Duccuong04/Design-Drone-from-Zero/readme.md

# Project: Design Drone from Zero

## 1. MATLAB Simulink

 Mô phỏng đáp ứng PID & fuzzy PID, đã được trình bày ở file thuyết minh, file MATLAB Simulink ở đây: [***MATLAB Simulink Drone***](<MATLAB Simulink>)

## 2. Hardware

Thiết kế mạch tay cầm cho drone sử dụng IC xử lý chính là STM32F103C8T6, mạch chính drone để điều khiển dùng STM32F407VET6

Các hình ảnh thiết kế được trình bày ở đây: [***Hardware***](Hardware/readme.md)

## 3. Code

Mạch tay cầm: [***Code Game Pad for Drone***](Code/GamePadforDrone)

Mạch xử lý chính: [***Code Main Drone***](Code/MainDrone)

## 4. Kết quả đã đạt được

Test đáp ứng PID với Input là Gyro và Joystick từ tay cầm: 

**https://youtu.be/HaZGvO9cnyQ**

**https://youtu.be/AUR3ovJpVSY**

Test cân bằng góc pitch/ roll

**https://youtu.be/xqhBPt9eMAI**

Video bay thực tế: 

https://drive.google.com/file/d/147RBULrgK9qIRCBWejau6amRLlQyX-BF/view?usp=sharing

Nhận xét:
- Về chức năng: Đã cân bằng được ba góc roll, pitch, yaw sử dụng bộ điều khiển PID. Điều khiển bằng tay cầm đáp ứng tốt
- Thuật toán đếm người sử dụng Camera Rasphberry Pi cho hiệu quả tốt và chính xác
- Dữ liệu GPS truyền về ở chế độ tự động bay còn lỗi, sẽ tiếp tục cải thiện sau
