Duccuong04/Design-Drone-from-Zero/Hardware/Algorithm.pptx

GY86 – IMU9DOF – HMC5883L

## Slide 2

1. Khởi tạo đối tượng IMU

IMU9DOF gy86(&hi2c1,11, 0x080E0000);

IMU9DOF sử dụng I2C1, sector flash = 11, địa chỉ flash = 0x080E0000.

2. Khởi động cảm biến trong main

Init cảm biến

if ((gy86.IsReadyToInterfaceMPU6050() != IMU9DOF_Result_Ok) || (gy86.IsReadyToInterfaceHMC5883L() != IMU9DOF_Result_Ok)) {
// Báo lỗi
}
if (gy86.Init() != HAL_OK) {
// Báo lỗi
}

→ gọi IsReadyToInterfaceMPU6050 / IsReadyToInterfaceHMC5883L để kiểm tra I2C.
→ gọi Init() (bên trong: SetupGyro(), SetupCompass(), SetupAutomaticReadCompass(), đọc/ghi flash để load hệ số calib).

## Slide 3

Chuẩn bị dữ liệu ban đầu

gy86.ReadRawAllParameter();
gy86.ReadCompass();
gy86.angleYaw = gy86.actualCompassHeading;
gy86.CalibGyro(); // hiệu chuẩn Gyro bằng 2000 mẫu

Ổn định giá trị accel trước khi vào vòng lặp chính

for (int i = 0; i <= 24; i++) gy86.shortAverageAccel_Z[i] = gy86.accel.z;
for (int i = 0; i <= 49; i++) gy86.longAverageAccel_Z[i] = gy86.accel.z;
gy86.shortTotalAccel_Z = gy86.accel.z * 25;
gy86.longTotalAccel_Z = gy86.accel.z * 50;

## Slide 4

3. Trong vòng lặp while(1)

Khi stateMachine = 0 (khởi động lần đầu):

gy86.CalibCompass(); // hiệu chỉnh la bàn, ghi vào flash
gy86.CalibLevel(&error); // calib cân bằng mặt phẳng, ghi offset accel vào flash

Trong vòng lặp chính mỗi chu kỳ:

gy86.ReadGyroAccel(); // đọc gyro + accel, trừ offset
gy86.ReadCompass(); // tính toán heading từ magnetometer
gy86.CalculateGyroInput(); // tính roll/pitch/yaw input từ gyro
gy86.ReadAngleRPY(); // tính góc Roll, Pitch, Yaw
gy86.setLevelAdjust(0, 0); // hiệu chỉnh cân bằng
gy86.VerticalAccelerationCalculations(); // tính gia tốc thẳng đứng, hỗ trợ ổn định độ cao

## Slide 5

4. Dòng dữ liệu IMU → PID → Motor

ReadGyroAccel() + ReadCompass() + ReadAngleRPY() → cập nhật gy86.gyro.rollInput, pitchInput, yawInput.

Gán vào PID:

pidForHorizontal.roll.inputValue = gy86.gyro.rollInput;
pidForHorizontal.pitch.inputValue = gy86.gyro.pitchInput;
pidForHorizontal.yaw.inputValue = gy86.gyro.yawInput;

- Sau đó pidForHorizontal.calculatePID() tính toán đầu ra PID.
- Cuối cùng, các giá trị PID + Throttle được cộng/trừ và đưa vào PWM ESC để điều khiển động cơ.

## Slide 6

- IsReadyToInterfaceMPU6050/HMC5883L → kiểm tra kết nối
- Init() → setup gyro + compass + đọc hệ số calib từ flash
- ReadRawAllParameter() + ReadCompass() → lấy giá trị ban đầu
- CalibGyro() → hiệu chuẩn gyro
- Khi stateMachine = 0: CalibCompass() + CalibLevel()
- Trong vòng lặp chính:
- ReadGyroAccel()
- ReadCompass()
- CalculateGyroInput()
- ReadAngleRPY()
- setLevelAdjust()
- VerticalAccelerationCalculations()

## Slide 7

GY86 – MS5611

## Slide 8

1. Khởi tạo đối tượng

Barometer ms5611(&hi2c1);

2. Trong main() – giai đoạn khởi tạo

Thiết lập thông số PID cho barometer:

ms5611.SetKgainPID(1.4, 0.2, 0.75, 400);

Cấu hình hệ số P, I, D và giới hạn đầu ra cho PID giữ độ cao

Kiểm tra kết nối với barometer:

if (ms5611.IsReadyToInterface() != BAROMETER_Result_Ok) {
// lỗi cảm biến -> reset drone
}

Gọi Init():

if (ms5611.Init() != HAL_OK) {
// lỗi init -> reset drone
}

## Slide 9

Hàm Init() gọi Reset() (gửi lệnh reset MS5611) và ReadProm() (đọc hệ số hiệu chuẩn trong PROM)

Ổn định bộ nhớ đệm áp suất trước khi vào vòng lặp chính:

for (int i = 0; i < 100 ; i++) {
ms5611.ReadAndCalculatePIDBarometer(flightMode, takeoffDetected,stateThrottle);
HAL_Delay(4);
}
ms5611.SetGroundPressure();

3. Trong vòng lặp while(1)

Chuẩn bị giá trị trung bình để tránh sai số ban đầu

ms5611.ReadAndCalculatePIDBarometer(flightMode, takeoffDetected, stateThrottle);

## Slide 10

Hàm này (trong barometer.cpp) thực hiện:
1. Luân phiên yêu cầu đọc nhiệt độ (RequestGetTemperatureData) và áp suất (RequestGetPressureData).
2. Lấy dữ liệu thô từ MS5611 (GetDataFromPreviousRequest).
3. Tính toán áp suất bù nhiệt (CompensatePressure).
4. Lọc nhiễu (average, complementary filter).
5. Cập nhật biến actualPressure.
6. Tính toán PID giữ độ cao bằng CalculateAltitudePID(...).
→ Kết quả: ms5611.pidOutputAltitude được cập nhật mỗi vòng lặp.

4. Sử dụng đầu ra PID barometer

Trong điều khiển ga động cơ:

if (takeoffDetected == 1 && stateMachine == 2) {
Throttle = throttle + 0;
if (flightMode == 2) {
Throttle = throttle + ms5611.GetPidOutputAltitude();
}
}

→ Nếu flightMode = 2 (Altitude hold) thì PID từ barometer (GetPidOutputAltitude()) sẽ bù vào giá trị throttle để giữ độ cao

## Slide 11

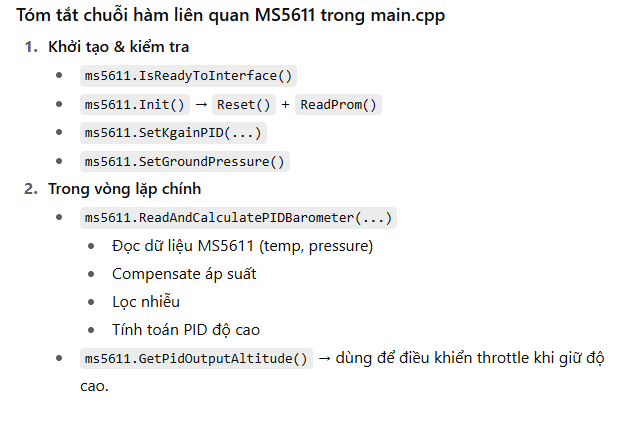
[picture p15: figure]

## Slide 12

## Slide 13

## Slide 14

## Slide 15
