Duccuong04/Design-Drone-from-Zero/Hardware/Drone.pdf

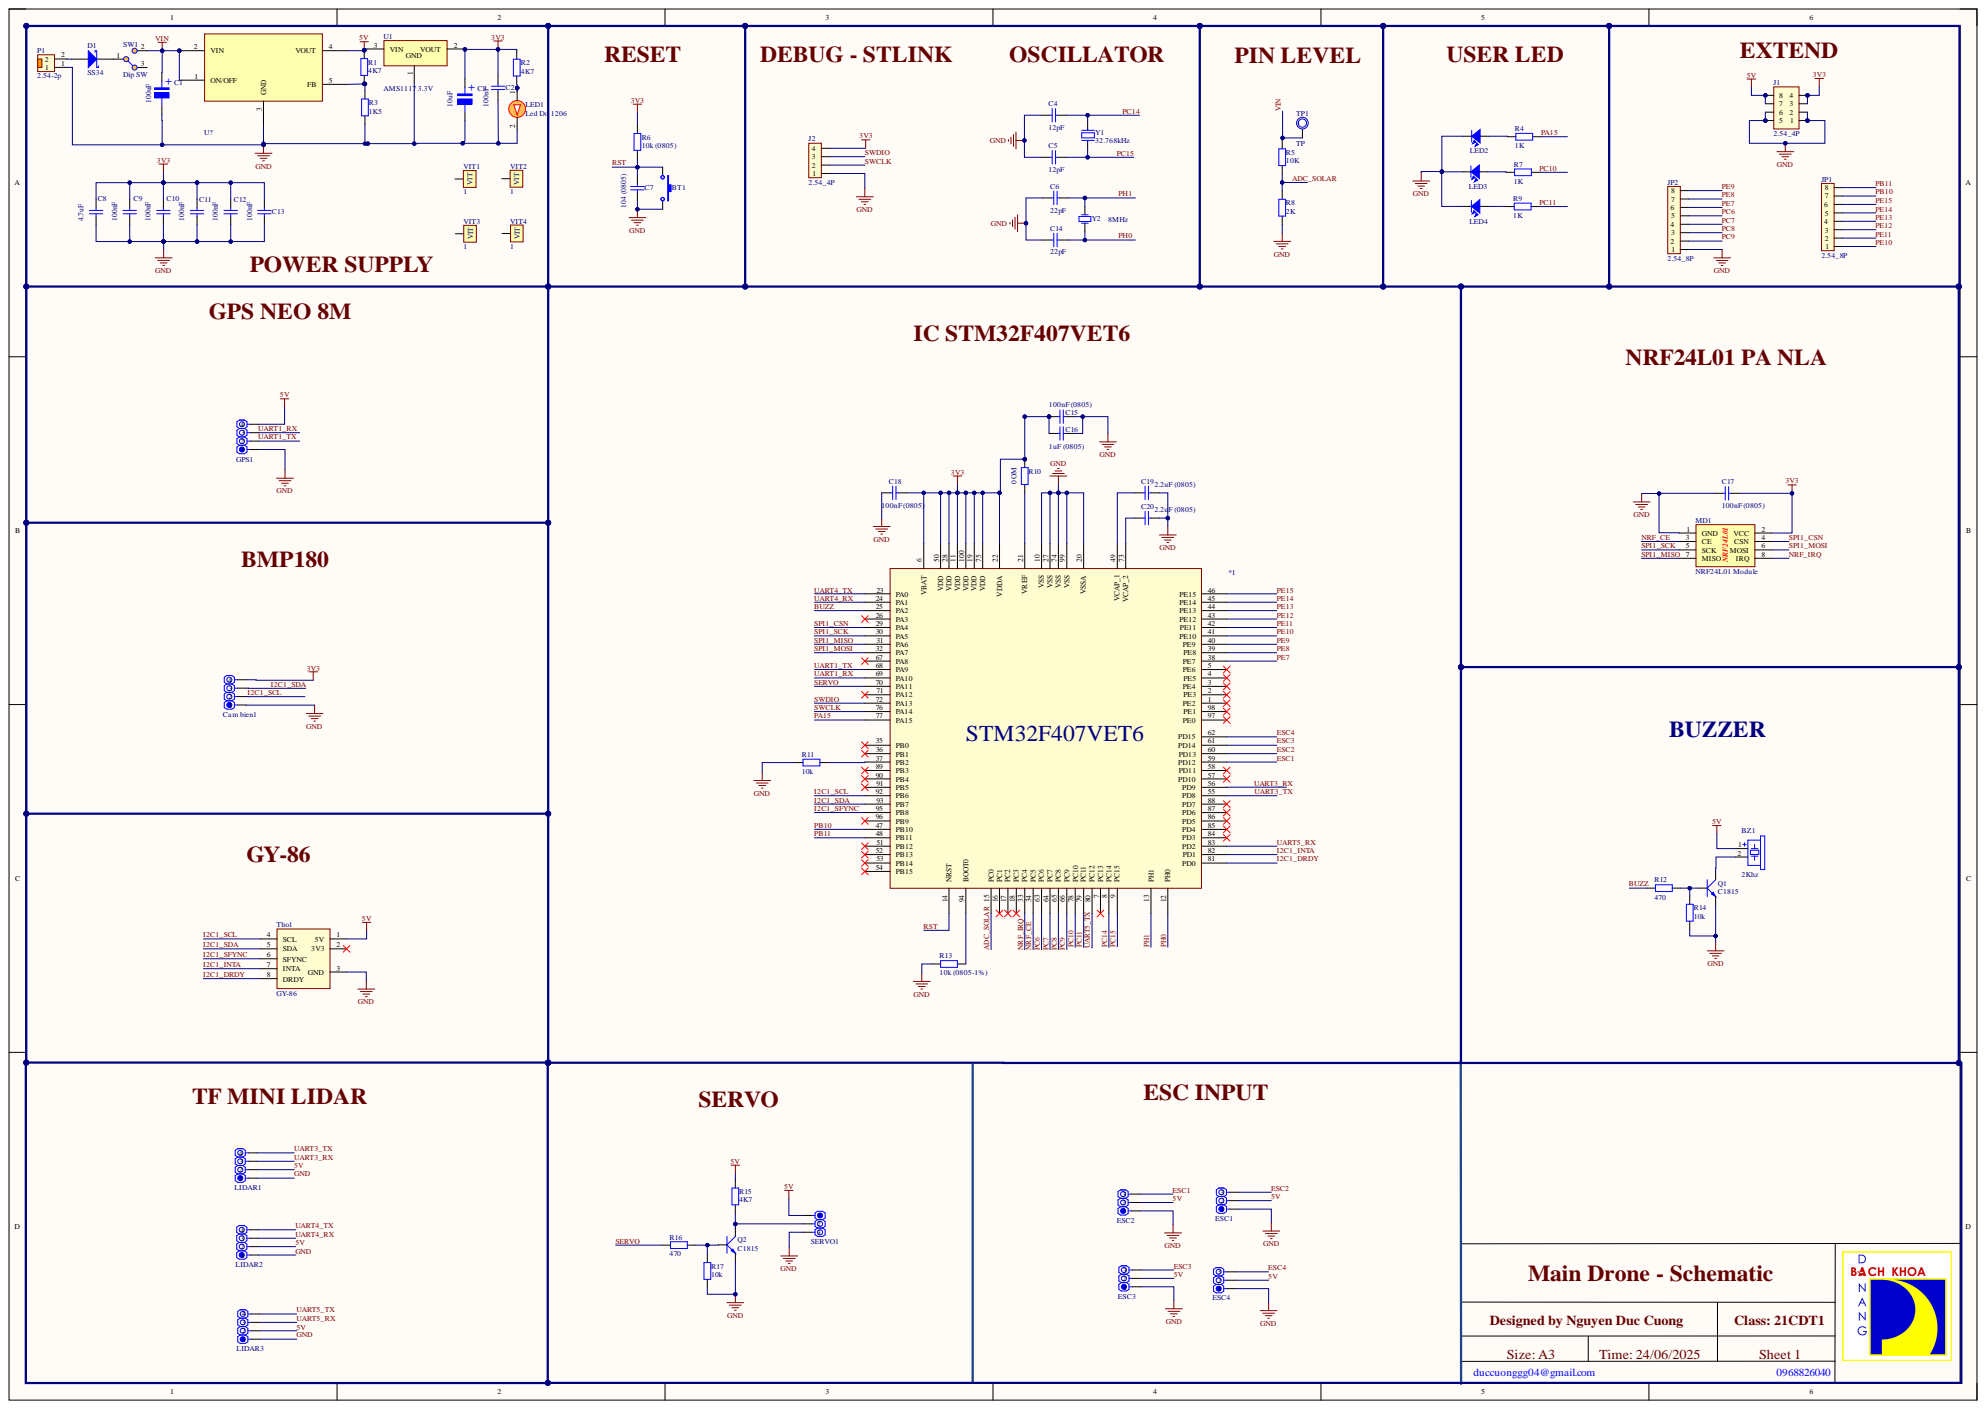
[picture p45: page 1]
