Duccuong04/Design-Drone-from-Zero/Hardware/DronePcb.pdf

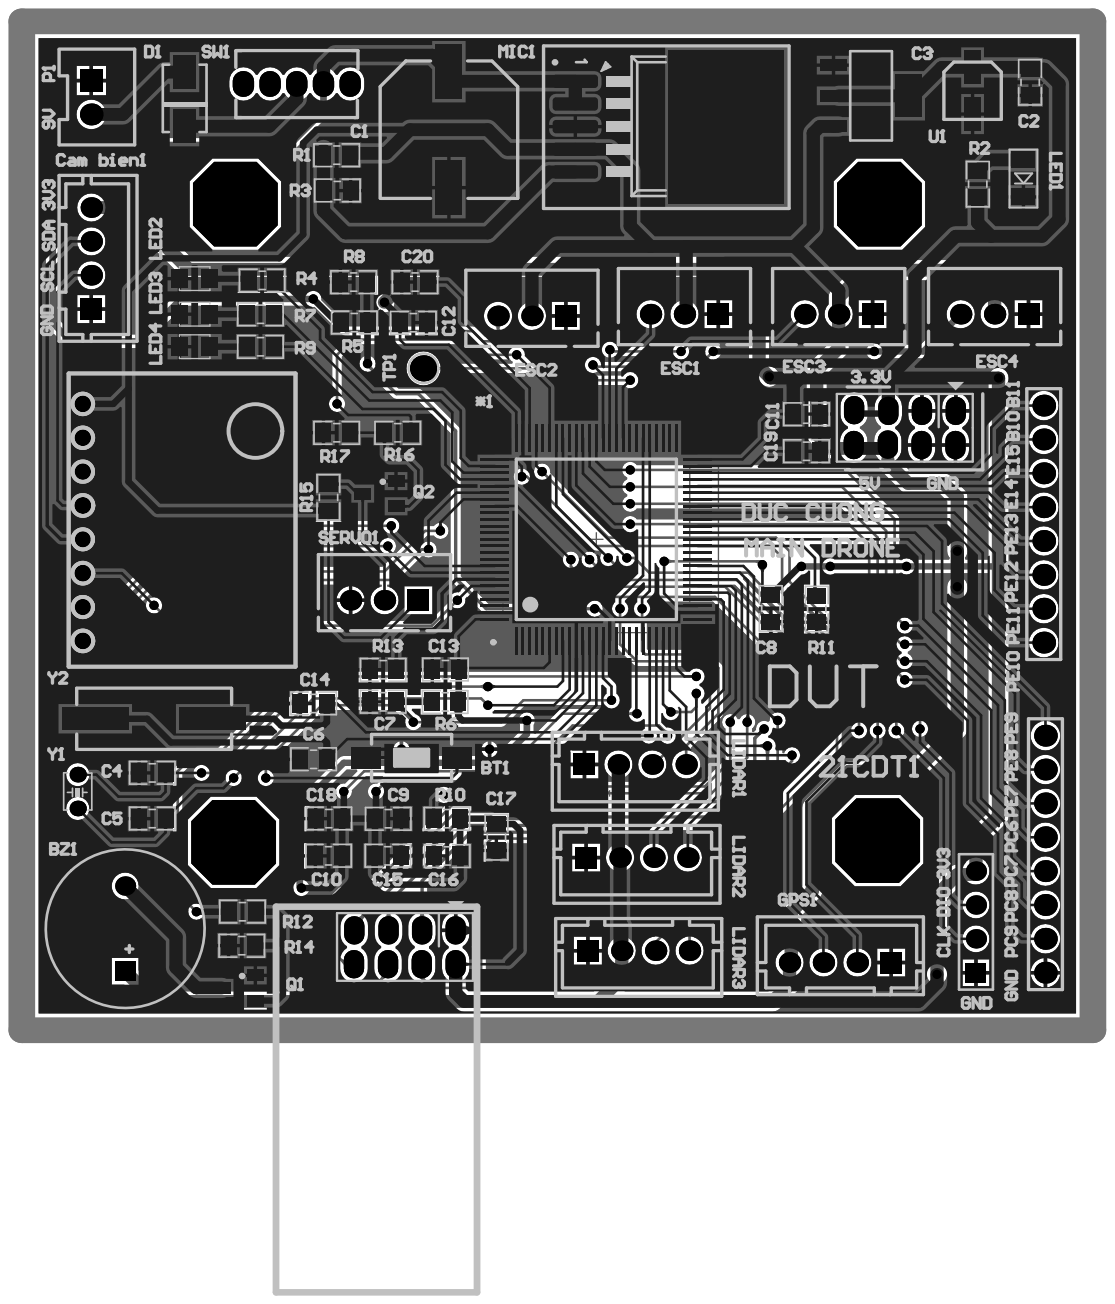
[picture p46: page 1]
