Duccuong04/Design-Drone-from-Zero/Hardware/Machtaycampcb.pdf

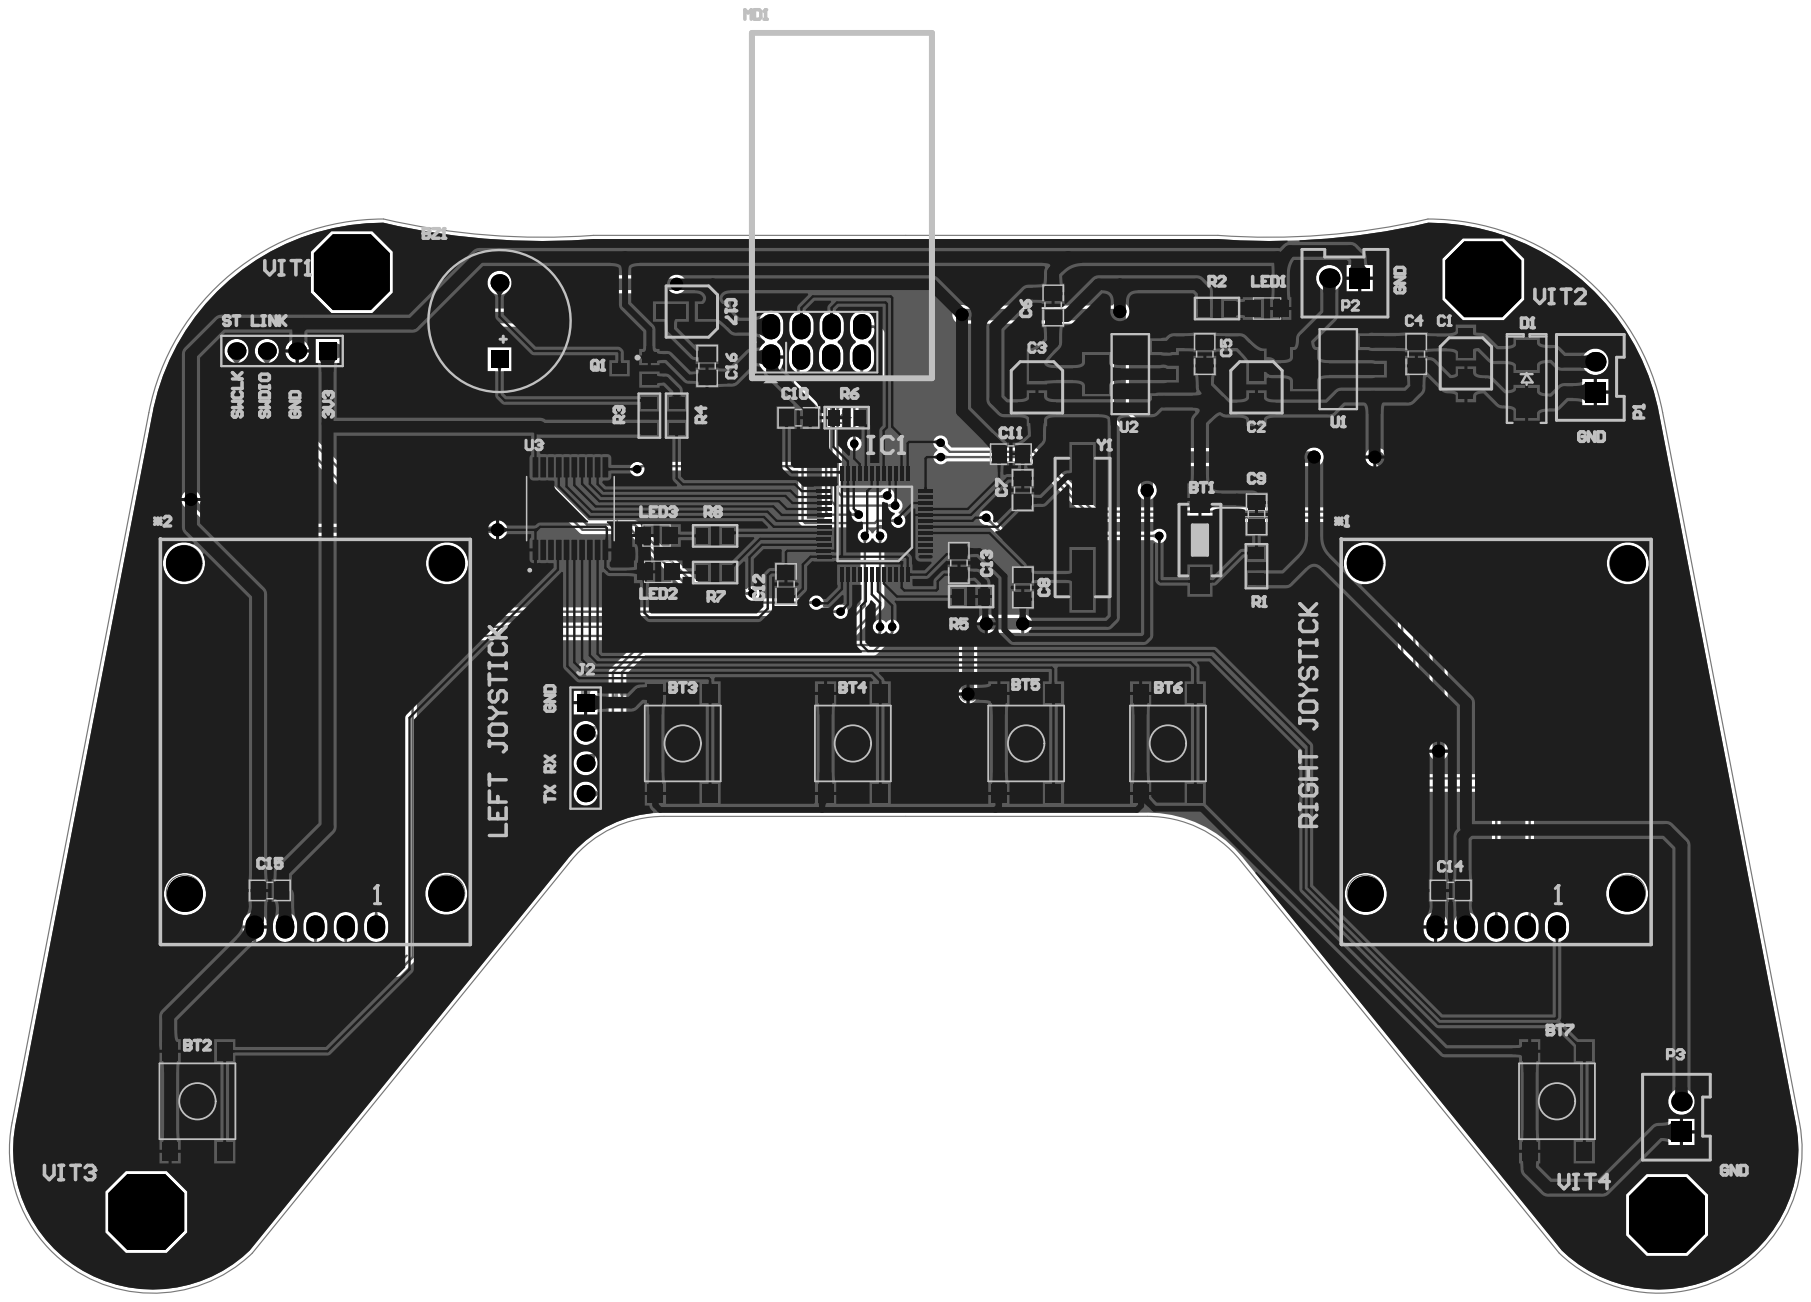
[picture p47: page 1]
