Duccuong04/Design-Drone-from-Zero/Hardware/Machtaycam.pdf

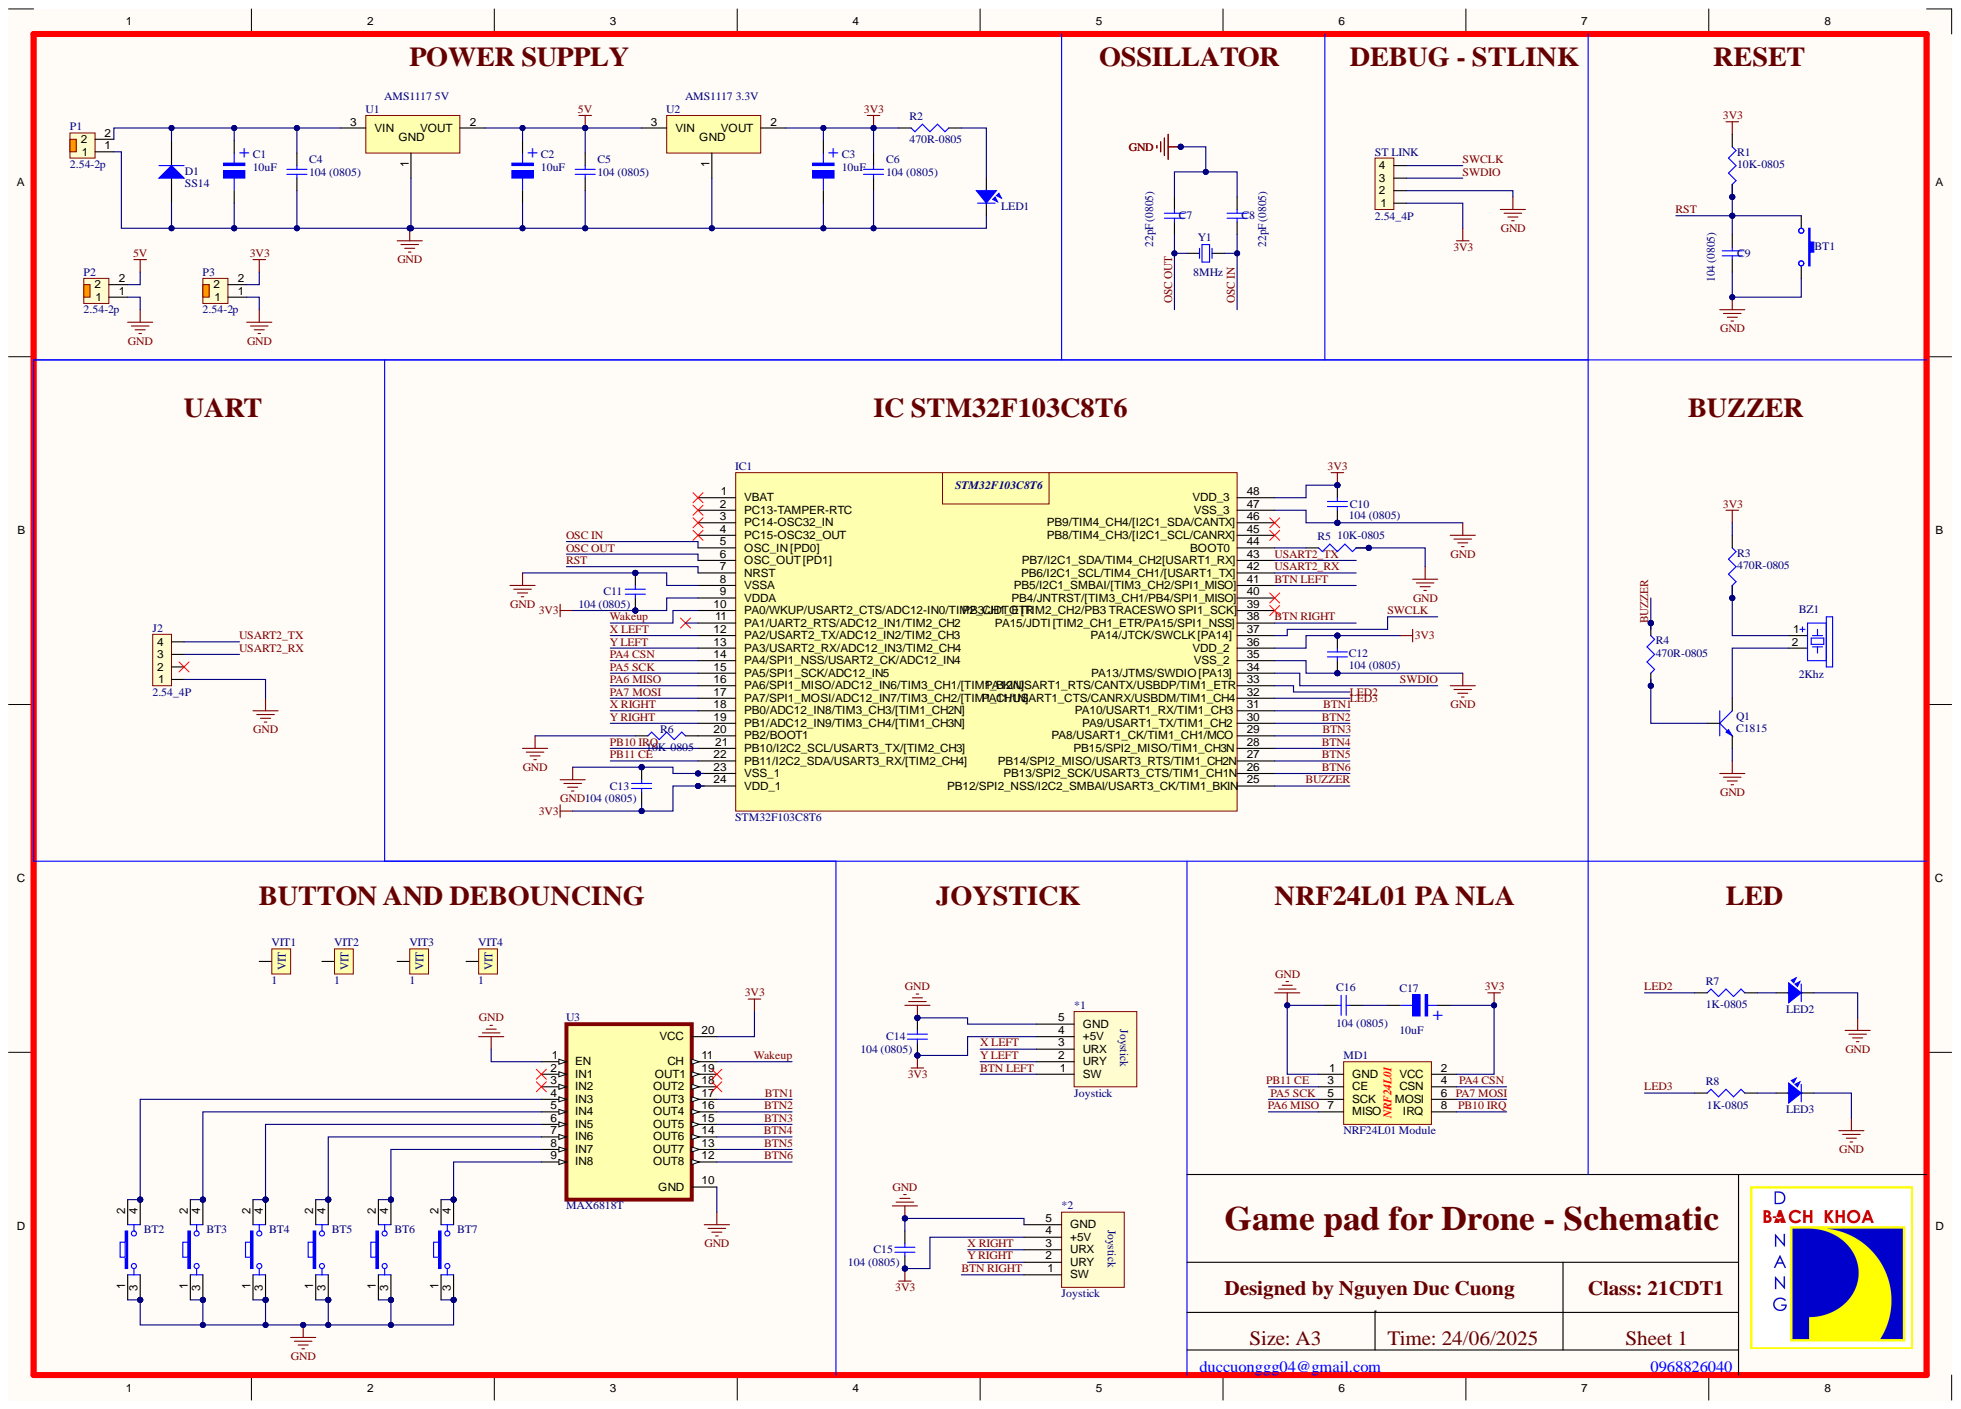
[picture p44: page 1]

VDDA 9 | GND
PA0/WKUP/USART2_CTS/ADC12-IN0/TIM2_CH1_ETR 10

Wakeup | PA1/UART2_RTS/ADC12_IN1/TIM2_CH2 11

Game pad for Drone - Schematic

X RIGHT | URX 3
